ejovrh/beba/beba.xlsx

Qty | Value | Device | Package | Parts | Description | mouser part no.
4 | 0.1uF / 25V | C-EUC0805 | C0805 | IDEAL_DIODE1:C1, IDEAL_DIODE2:C1, IDEAL_DIODE3:C1, TPS630701-1:C11 | CAPACITOR, European symbol | 81-GCM21BR71E104KA7L
3 | 100k | R-EU_R0805 | R0805 | MCP73871-1:R5, MCP73871-1:R8, TPS630701-1:R6 | RESISTOR, European symbol | 667-ERJ-P06F1003V
1 | 10k | R-EU_R0805 | R0805 | TPS630701-1:R1 | RESISTOR, European symbol | 667-ERJ-P06F1002V
7 | 10uF / 25V | C-EUC0805 | C0805 | MCP73871-1:C1, MCP73871-1:C2, MCP73871-1:C3, TPS630701-1:C8, TPS630701-1:C9, TPS630701-1:C10, TPS630701-1:C12 | CAPACITOR, European symbol | 81-GRM21BR61E106MA3L
1 | 150k | R-EU_R0805 | R0805 | MCP73871-1:R9 | RESISTOR, European symbol | 667-ERJ-P06F1503V
5 | 1k | R-EU_R0805 | R0805 | MCP73871-1:R1, MCP73871-1:R2, MCP73871-1:R3, MCP73871-1:R6, MCP73871-1:R7 | RESISTOR, European symbol | 667-ERJ-P06F1001V
3 | 22u / 25V | C-EUC0805 | C0805 | TPS630701-1:C13, TPS630701-1:C14, TPS630701-1:C15 | CAPACITOR, European symbol | 81-KRM21FR61E226MF1L
2 | 3SMBJ5921B-TP | ZENER-DIODEDO214AA | DO214AA | D1 | Zener Diode | 833-3SMBJ5921B-TP
1 | 6800uF / 16V | C-POL | TH | MCP73871-1:C16 | CAPACITOR, European symbol | 647-UFW1C682MHD
3 | 49k9 | R-EU_R0805 | R0805 | R2, R4 | RESISTOR, European symbol | 667-ERJ-P06F4992V
1 | MCP73871-2CC | MCP73871-2AAI/ML | QFN50P400X400X100-21N | MCP73871-1:IC7 | IC, BATTERY CHARGER, 1A | 579-MCP73871T2CCIML
2 | 75k | R-EU_R0805 | R0805 | R1, R3 | RESISTOR, European symbol | 667-ERJ-PB6D7502V
3 | LM74670QDGKTQ1 | LM74670 | VSSOP-8 | IDEAL_DIODE1:IC2, IDEAL_DIODE2:IC2, IDEAL_DIODE3:IC2 | IC, Ideal Diode Controller | 595-LM74670QDGKRQ1
1 | LTST-C230KGKT - green | LEDSML1206 | SML1206 | MCP73871-1:LED2 | LED | 859-LTST-C230KGKT
1 | LTST-C230KRKT - red | LEDSML1206 | SML1206 | MCP73871-1:LED1 | LED | 859-LTST-C150KRKT
1 | LTST-C230KSKT - yellow | LEDSML1206 | SML1206 | MCP73871-1:LED3 | LED | 859-LTST-C230KSKT
1 | MUSBR-05-F-O-B-SM-A | MUSBR-05-F-O-B-SM-A | SAMTEC_MUSBR-05-F-O-B-SM-A | USB1 | USB - mini B USB 2.0 Receptacle | 200-MUSBR05FOBSMA
1 | NTC | SMD5 | SMD2,54-5,08 | PAD5 | NTC Thermistor | 81-NXFT15XH103FEAB45
3 | SQ2310ES-T1_BE3 | BSS123 | SOT23 | IDEAL_DIODE1:Q2, IDEAL_DIODE2:Q2, IDEAL_DIODE3:Q2 | N-CHANNEL MOS FET | 78-SQ2310ES-T1_BE3
1 | TPS630701RNMT | TPS630701 | VQFN | TPS630701-1:IC1 | IC, Switching Voltage Regulator | 595-TPS630701RNMT
1 | USB-A-S-S-B-SM2 | USB-A-S-X-X-SM2 | SAMTEC_USB-A-S-X-X-SM2 | USB2 | USB-A USB 2.0 Receptacle | 200-USBASSBSM2
1 | XFL4020-152MEC | XFL4020-152MEC | 1616 | TPS630701-1:L2 | Fixed Inductor 1.5uH | 994-XFL4020-152MEC
