ejovrh/beba/beba.dxf

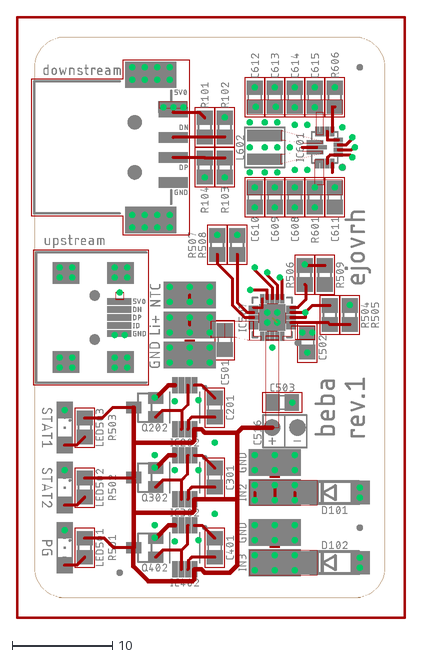
[picture p1: CAD file, 2022-05-29]
beba.dxf
39.0 x 60.2
