ejovrh/beba/(list of files, cad)

Other CAD files:
beba.dwg
