ejovrh/beba/beba.brd

## EAGLE design beba.brd (2022-06-02)

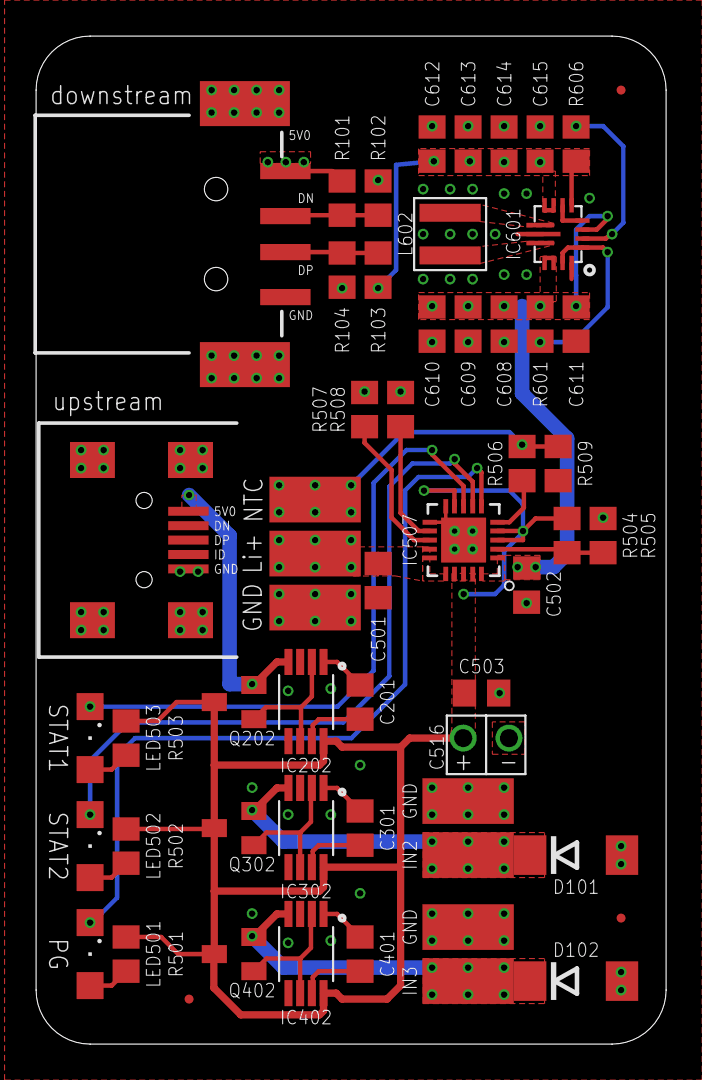
[picture p2: board beba.brd from above]

Board: 2 copper layers, 35.0 x 56.0 mm, 56 parts (0 on the bottom side), 35 nets.

Parts:
C201, C301, C401: 0.1uF / 25V; C0805
C501, C502, C503, C608, C609, C610, C612: 10uF / 25V; C0805
C516: 6800uF / 16V; TH
C611: 0.1uF / 50V; C0805
C613, C614, C615: 22u / 25V; C0805
D101, D102: 3SMBJ5921B-TP; DO214AA
FID1, FID2, FID3: fiducial; FIDUCIAL_0.5MM
IC202, IC302, IC402: LM74670QDGKTQ1; VSSOP-8
IC507: 579-MCP73871T2CCIML; QFN50P400X400X100-21N
IC601: TPS630701RNMT; VQFN
L602: XFL4020-152MEC; 1616
LED501: LTST-C230KGKT - green; SML1206
LED502: LTST-C230KRKT - red; SML1206
LED503: LTST-C230KSKT - yellow; SML1206
PAD101: IN2; SMD2,54-5,08
PAD102, PAD104, PAD107: GND; SMD2,54-5,08
PAD103: IN3; SMD2,54-5,08
PAD105: NTC; SMD2,54-5,08
PAD106: Li-Ion +; SMD2,54-5,08
Q202, Q302, Q402: SQ2310ES-T1_BE3; SOT23
R101, R103: 75k; R0805
R102, R104: 49k9; R0805
R501, R502, R503, R506, R507: 1k; R0805
R504: 50k; R0805
R505, R508, R606: 100k; R0805
R509: 150k; R0805
R601: 10k; R0805
USB101: MUSBR-05-F-O-B-SM-A; SAMTEC_MUSBR-05-F-O-B-SM-A
USB102: USB-A-S-S-B-SM2; SAMTEC_USB-A-S-X-X-SM2

Connections:
5V0: C612.2, C613.2, C614.2, C615.2, IC601.5-FB, IC601.7-VOUT, IC601.8-VOUT, IC601.VOUT, R101.2, R103.2, R606.2, USB102.1_5V0
GND: C501.2, C502.2, C503.2, C516.NEG, C608.1, C609.1, C610.1, C611.1, C612.1, C613.1, C614.1, C615.1, D101.A, D102.A, IC507.10_GND1, IC507.11_GND2, IC507.GND2, IC507.GND3, IC507.GND4, IC507.GND5, IC507.GND6, IC601.4-GND, IC601.6-FB2, IC601.10-PGND, IC601.15-VSEL, PAD102.1, PAD104.1, PAD107.1, R102.1, R104.1, R505.1, R507.2, R508.2, R509.2, USB101.5_GND, USB101.G1, USB101.G2, USB101.G3, USB101.G4, USB102.4_GND, USB102.G1, USB102.G2
IDEAL_DIODE1:GATE_DRIVER: IC202.GATE_DRIVE, IC202.GATE_PULLD, Q202.1
IDEAL_DIODE1:VCAPH: C201.2, IC202.VCAPH
IDEAL_DIODE1:VCAPL: C201.1, IC202.VCAPL
IDEAL_DIODE2:GATE_DRIVER: IC302.GATE_DRIVE, IC302.GATE_PULLD, Q302.1
IDEAL_DIODE2:VCAPH: C301.2, IC302.VCAPH
IDEAL_DIODE2:VCAPL: C301.1, IC302.VCAPL
IDEAL_DIODE3:GATE_DRIVER: IC402.GATE_DRIVE, IC402.GATE_PULLD, Q402.1
IDEAL_DIODE3:VCAPH: C401.2, IC402.VCAPH
IDEAL_DIODE3:VCAPL: C401.1, IC402.VCAPL
MCP73871-1:LED1_A: LED501.A, R501.2
MCP73871-1:LED2_A: LED502.A, R502.2
MCP73871-1:LED3_A: LED503.A, R503.2
MCP73871-1:PG: IC507.!6_PG!, LED501.C
MCP73871-1:PROG1: IC507.13_PROG1, R507.1
MCP73871-1:PROG3: IC507.12_PROG3, R508.1
MCP73871-1:STAT1: IC507.8_STAT1/!LBO!, LED503.C
MCP73871-1:STAT2: IC507.7_STAT2, LED502.C
MCP73871-1:THERM: IC507.5_THERM, R506.1
MCP73871-1:VPCC: IC507.2_VPCC, R504.1, R505.2
NTC: PAD105.1, R506.2, R509.1
TPS630701-1:L1: IC601.11-L1, L602.P$1
TPS630701-1:L2: IC601.9-L2, L602.P$2
TPS630701-1:N$8: IC601.1-PS/S, IC601.14-EN, R601.1
TPS630701-1:PG1: IC601.2-PG, R606.1
TPS630701-1:VAUX: C611.2, IC601.3-VAUX
USBDN: R101.1, R102.2, USB102.2_DN
USBDP: R103.1, R104.2, USB102.3_DP
VINPUT1: IC202.ANODE, Q202.2, USB101.1_VCC
VINPUT2: D101.C, IC302.ANODE, PAD101.1, Q302.2
VINPUT3: D102.C, IC402.ANODE, PAD103.1, Q402.2
V_INPUT: C503.1, C516.POS, IC202.CATHODE, IC302.CATHODE, IC402.CATHODE, IC507.3_SEL, IC507.4_PROG2, IC507.9_!TE!, IC507.17_CE, IC507.18_IN1, IC507.19_IN2, Q202.3, Q302.3, Q402.3, R501.1, R502.1, R503.1, R504.2
V_LIION+: C501.1, IC507.14_VBAT1, IC507.15_VBAT2, IC507.16_BAT_SENSE, PAD106.1
V_REGULATED: C502.1, C608.2, C609.2, C610.2, IC507.1_OUT1, IC507.20_OUT2, IC601.12-VIN, IC601.13-VIN, IC601.VIN, R601.2
