ejovrh/beba/(commit log)

2017-05-09 - quick and dirty schematic and layout of a powerbank device
    [beba.brd, beba.sch]
2017-05-09 - added usb socket and datasheets
2017-05-28 - added DE1205-18 Power Inductor library
2017-05-28 - corrected issues with component placement, power inductor footprint, etc.
    [beba.GBL, beba.GBO, beba.GBP, beba.GBS, beba.GTL, beba.GTO, beba.GTP, beba.GTS]
2017-05-28 - added MX500075-1517 USB Mini-B straight socket datasheet
2017-05-28 - further minor corrections
    [beba.GBL, beba.GBO, beba.GBP, beba.GBS, beba.GTL, beba.GTO, beba.GTP, beba.GTS]
2017-08-20 - minor corrections, added bom
    [beba.GBL, beba.GBO, beba.GBP, beba.GBS, beba.GTL, beba.GTO, beba.GTP, beba.GTS]
2022-04-24 - rewrote schematic into sheets
    [beba.brd, beba.sch]
2022-04-27 - finalized rev.1 schematic, ERC checks out OK - compiled BOM
    [beba.sch, beba.xlsx]
2022-04-28 - moved over voltage protection diode to forward of ideal diode and duplicated it for the other non-USB input channel - updated BOM
    [beba.sch, beba.xlsx]
2022-04-28 - minor updates to components
    [beba.sch]
2022-04-28 - added fiducials
    [beba.sch]
2022-04-28 - uploaded brd to fab - created gerber files - rev.1 finished
    [beba.GBL, beba.GBO, beba.GBP, beba.GBS, beba.GTL, beba.GTO, beba.GTP, beba.GTS]
2022-05-28 - changed positions of red and green led
    [beba.brd, beba.sch]
2022-05-29 - optimization of BOM: replaced MCP73871's VPCC 50k resistor with 49.9k
    [beba.sch, beba.xlsx]
2022-05-29 - exchanged passives (capacitors with higher voltage, resistors with higher power rating), updated BOM
    [beba.brd, beba.sch, beba.xlsx]
2022-05-29 locked PCB edge, USB connector and LED positions
    [beba.brd]
2022-05-29 case development: added eagle export (dxf) and newly created dwg
    [beba.dwg, beba.dxf]
2022-06-02 - MCP73871's input capacitor: moved square bottom pour from positive (falsely placed) to negative (correct placement), added same square to top layer
    [beba.brd]
